multicatch/esp32_eink_picture_frame/img/photo4.jpeg

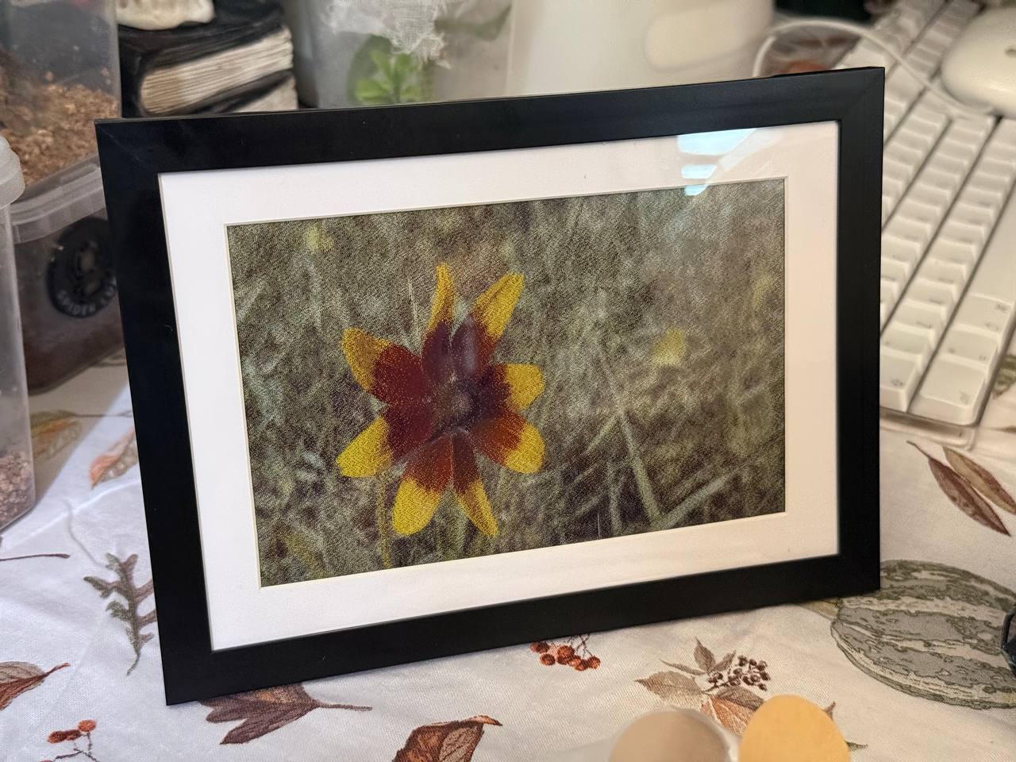
img/photo4.jpeg
