multicatch/esp32_eink_picture_frame/(commit log)

2026-09-23 update sleep time & BLE upload fix
    [esp32_ble.ino]
2026-09-23 update picture frame uploader
2026-09-26 add photo of the picture frame
